mhdsilva/flywire-arduino/README.md

# FlyWire on Arduino 🪰 — a fly brain driving an Arduino

**A real *Drosophila melanogaster* brain circuit running on a laptop CPU and
controlling physical hardware.**

I took the public [FlyWire](https://flywire.ai) connectome — the synapse-by-synapse map of the
fly brain — extracted the subcircuit that detects "something approaching" and triggers escape, and
wired it into an Arduino. Activity in the *Giant Fiber* (DNp01) continuously controls
the amplitude and frequency of a servo oscillation. When that activity fades,
the servo returns to rest. The connections drive the neural response; a short
rate filter and an engineered oscillator translate it into physical movement.

> **TL;DR:** A real fruit-fly connectome (FlyWire FAFB v783) reduced to a 583-neuron
> looming→escape subcircuit, simulated with a sparse LIF model on a laptop CPU (~0.9× real
> time) and closed into a physical loop via an Arduino: potentiometer = looming sense, three
> LEDs = the three neural stages, servo = flapping wings. Recent motor firing
> controls the movement continuously, with no predetermined flight duration.

---

## How it works

```
   [Arduino UNO]                          [Laptop]                        [Arduino UNO]
   potentiometer  ─── serial 115200 ───►  connectome FlyWire ─── serial ───►  3 LEDs
   (the "looming")    "S <ldr> <ntc>      LC4/LPLC2 → inter → DNp01           (stages)
                       <pot> <btn>"       (583 neurons, LIF, CPU)            servo
                                          ▲                                     (wings)
                                          └──────────── "L <s> <i> <m> <ang>" ─┘
```

- The **Arduino is the body**: it reads sensors, moves the servo, lights LEDs. Deliberately dumb.
- The **laptop is the brain**: it simulates the connectome and maps motor activity to servo commands.
- The loop closes at ~50 Hz over USB serial.

The potentiometer lets you "startle" the fly: a slow ramp is ignored, a sharp turn
becomes a strong *looming* that sweeps through the circuit and makes DNp01 fire.

## The brain (real data)

The data comes from Codex/FlyWire, snapshot **FAFB v783** (the complete adult brain of
`Drosophila`, ~139,255 neurons).

The subcircuit is extracted by `brain/build_circuit.py`:

| Role | Neurons | What it is |
|---|---|---|
| **Sensory** | 314 | LC4 + LPLC2 — visual *looming* detectors |
| **Interneurons** | 267 | what connects the two |
| **Motor** | 2 | DNp01 — the *Giant Fiber*, escape command |
| **Total** | **583** | 4,799 weighted connections between neuron pairs |

Simulation: sparse LIF in numpy/scipy (`brain/lif.py`), `dt = 0.1 ms`, `tau_m = 20 ms`,
`tau_syn = 5 ms`. Weights = synapse count, with sign by neurotransmitter
(GABA = inhibitory). Runs at **~0.9 s of CPU per 1 s of brain** on an i5-1135G7 — that is,
practically real time, with no GPU.

> The response depends on both the wiring and the chosen model parameters. In `--dry-run`,
> `stim = 0` → the motor stays quiet; `stim = 0.2` → it fires.

## The behaviour

`FlightBehavior` in `brain/run_brain.py` continuously reads motor spikes:

1. Estimate the mean DNp01 firing rate with a **100 ms exponential filter**.
2. Use that rate to set oscillation amplitude (up to ±50° around 90°) and
   frequency (0.7–2 Hz while active), with a command speed limit of 300°/s.
3. Keep sensing during movement: new activity can strengthen or sustain it.
4. As the rate falls below the readout threshold, return to 90°. Ignore sensor
   input for 0.5 s after this transition to reduce landing noise.

There is **no random duration or flight timer**. Brief stimuli now produce brief
movements: this circuit did not sustain seconds of motor firing after a short
pulse. The smoothing, activity thresholds and sinusoid remain engineered choices;
the oscillation itself does not emerge from the neural network. The green LED
reports motor spikes in the current window, so it can go dark while the smoothed
servo output is still returning to rest.

Measurements, the readout equations and reproduction commands are in
[`docs/NEURAL-CONTROL.md`](docs/NEURAL-CONTROL.md).

The LDR-to-servo path was tested on the physical Arduino on **2026-09-12**.
After observing the brief movements, the operator chose to preserve the current
neural response rather than extend it in the servo controller. The
[bench record and decision](docs/NEURAL-CONTROL.md#physical-bench-trial--2026-09-12)
include the results and the limits of that functional check.

### Two ways to startle it

`--sensor` picks what drives the looming stimulus:

- **`--sensor pot`** (default) — the potentiometer on **A2**. *Approaching* = a sharp
  counter-clockwise turn.
- **`--sensor ldr`** — the light sensor on **A0**. *Approaching* = a sudden rise in light:
  keep the room dark (LDR ≈ 50) and arrive with a flashlight. The light is the "predator" and
  the fly bolts. (You can invert the staging — lit at rest, a hand casts a shadow — by flipping
  the LDR `direction` to `-1` in `SENSORS`.)

Both share the same filtering: a median filter to kill spikes, a dead band so that noise and
slow changes are ignored, and a refractory period after each escape.

## Hardware

Wiring schematic

Eletrogate "Kit Start" kit (Arduino UNO R3):

| Component | Pin | Role in the project |
|---|---|---|
| Micro servo SG90 | 9 | wings (flies) |
| Red LED | 5 | **sensory** stage (LC4/LPLC2) |
| Yellow LED | 6 | **interneuron** |
| Green LED | 7 | **motor** (Giant Fiber) |
| Potentiometer 10 kΩ | A2 | *looming* — the startle (`--sensor pot`) |
| LDR (light) | A0 | *looming* — a flashlight arriving (`--sensor ldr`) |
| NTC 10 kΩ | A1 | *(optional)* temperature |
| Button | 2 | *(optional)* |
| Buzzer | 8 | *(optional)* |

Assembly and wiring details are in the header of `board/flywire/flywire.ino`.

Full build guide — bill of materials, breadboard basics, step-by-step wiring,
power/noise notes, bench self-test and troubleshooting:
[`docs/HARDWARE.md`](docs/HARDWARE.md). The diagram above is generated by
`docs/make_schematic.py`.

### Noise protection (bench learning)

The servo injects noise into the rails when it moves, and that shows up in the pot reading. Two
capacitors help:

- **100 nF** (ceramic) between the analog input (**A2** for the pot, or **A0** for the LDR) and
  **GND** — filters high-frequency noise at the input.
- **100 µF** (electrolytic, mind the polarity) between **5 V and GND** near the servo — current
  reserve for the peaks.

In addition, the Python controller has a median filter, a dead band and a brief
input guard after motor activity subsides. Input remains live during movement,
so physical filtering is still needed to avoid servo noise sustaining activity.

## How to run

### 1. Tools

```bash
# arduino-cli (no sudo, inside the project)
mkdir -p bin && curl -fL https://downloads.arduino.cc/arduino-cli/arduino-cli_latest_Linux_64bit.tar.gz \
  | tar -xz -C bin arduino-cli
export PATH="$PWD/bin:$PATH"
arduino-cli core install arduino:avr
arduino-cli lib install Servo

# python
python3 -m venv .venv
.venv/bin/pip install pyserial numpy scipy pandas

# serial port access (once; requires re-login)
sudo usermod -a -G dialout "$USER"
```

### 2. Data and circuits

```bash
.venv/bin/python brain/fetch_data.py      # downloads the FlyWire data (~50 MB)
.venv/bin/python brain/build_circuit.py   # generates brain/data/circuit.npz
```

> If you cloned the repo, `circuit.npz` already comes ready — you can skip this step and just run.

### 3. Flash the Arduino

```bash
arduino-cli compile --fqbn arduino:avr:uno --upload -p /dev/ttyACM0 board/flywire
```

On boot it runs a self-test: sweeps the servo, lights the LEDs in sequence, beeps the buzzer
(if connected). If you see this, the hardware is alive.

### 4. Run the brain

```bash
# without hardware (simulation only)
.venv/bin/python brain/run_brain.py --dry-run --stim 0.2 --seconds 1
.venv/bin/python brain/run_brain.py --fake --seconds 14

# real loop, potentiometer: a sharp twist startles it
cd brain && sg dialout -c '../.venv/bin/python -u run_brain.py --port /dev/ttyACM0 --seconds 0'

# real loop, light sensor: keep the room dark, arrive with a flashlight
cd brain && sg dialout -c '../.venv/bin/python -u run_brain.py --port /dev/ttyACM0 --sensor ldr --seconds 0'
```

`--seconds 0` runs until you press Ctrl-C.

## Verification

```bash
.venv/bin/python -B -m unittest discover -s tests -v
```

The 12 tests cover the continuous readout, the real saved neural circuit, both
sensor filters, synthetic and simulated serial operation, and reset after a
serial reconnection. Test details and pulse-response reproduction commands are
in [`docs/NEURAL-CONTROL.md`](docs/NEURAL-CONTROL.md).

## Engineering notes (what broke along the way)

Worth recording, because it was the most interesting part:

- **Serial buffer**: the Uno transmits sensors at 50 Hz. If the host does not drain the reading, the
  board's TX buffer fills up, its loop blocks and the PC's `write()` hangs forever. Solution:
  always drain and `write_timeout=1`.
- **`dt ≈ 0` with a full buffer**: processing several delayed samples with the same clock made
  `d(pot)/dt` explode and the noise turn into "looming". Solution: process only the most recent sample
  and use the nominal `dt` (20 ms).
- **Renewable flinch**: timer extensions once made jitter prolong movement. The
  current readout uses a continuously filtered motor rate instead of renewing a timer.
- **Noise cycle**: noise fires → servo moves → servo injects noise → fires again.
  Solution: refractory period + capacitors.
- **The SG90 is positional**: it does not spin 360°, it only goes from 0 to 180° and holds. That is not a bug.

## Experiments

The bench demo is also a bench for measurements. [`docs/EXPERIMENTS.md`](docs/EXPERIMENTS.md)
fixes the design — a shared stimulus protocol, honest metrics, and four experiments:
**ablation** (which neurons are necessary), **null model** (does the specific wiring
matter, or would any graph with the same degree sequence do?), **dose–response** (how
sharp the threshold is) and **latency** (in-silico vs the hardware loop).

The design was written before the code, so the experiments cannot be tuned into
telling a nicer story afterwards — and it paid off: at a single near-threshold
stimulus the ablation looked like "LC4 and LPLC2 are each individually necessary",
which the amplitude sweep showed to be an artefact.

Results and the honest reading: [`experiments/FINDINGS.md`](experiments/FINDINGS.md).
The code and commands: [`experiments/README.md`](experiments/README.md).

## What is real and what is simplified

**Real:** the topology of the connections (who connects to whom, with how many synapses) and the
identity of the neurons (LC4, LPLC2, DNp01) come from the connectome. Neural activity
depends on that wiring and the configured LIF parameters.

**Simplified:** the neuron model is LIF (not biophysical); synapses are static; the
neurotransmitters are treated as excitatory (GABA inhibitory); no plasticity; the body
is a servo, not real biomechanics. The rate filter, servo oscillator, thresholds
and movement limits are engineered mappings. It is a serious *toy*, not a paper.

## License and attribution

Code: **MIT** (see `LICENSE`).
Connectome data and derived artefacts (`brain/data/circuit.npz`): **CC BY-NC 4.0**
(non-commercial), from the FlyWire consortium.

References:

- Dorkenwald, S. et al. *Neuronal wiring diagram of an adult brain.* Nature (2024).
- Schlegel, P. et al. *Whole-brain annotation and multi-connectome cell typing of Drosophila.* Nature (2024).
- Shiu, P. K. et al. *A leaky integrate-and-fire computational model based on the connectome of the entire adult Drosophila brain.* Nature (2024).
- FlyWire / Codex — https://codex.flywire.ai
