mhdsilva/flywire-arduino/docs/cover.png

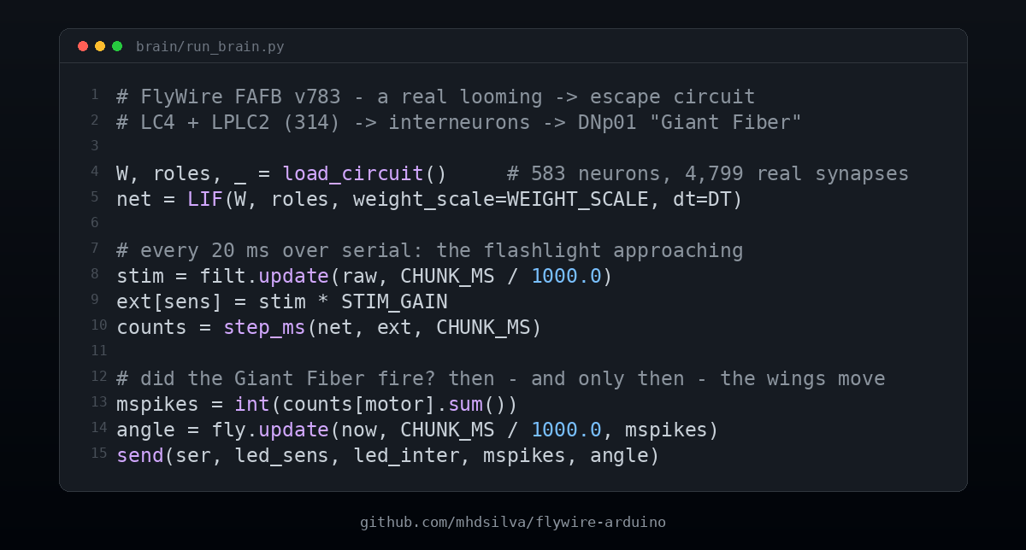
docs/cover.png
