mhdsilva/flywire-arduino/docs/schematic.png

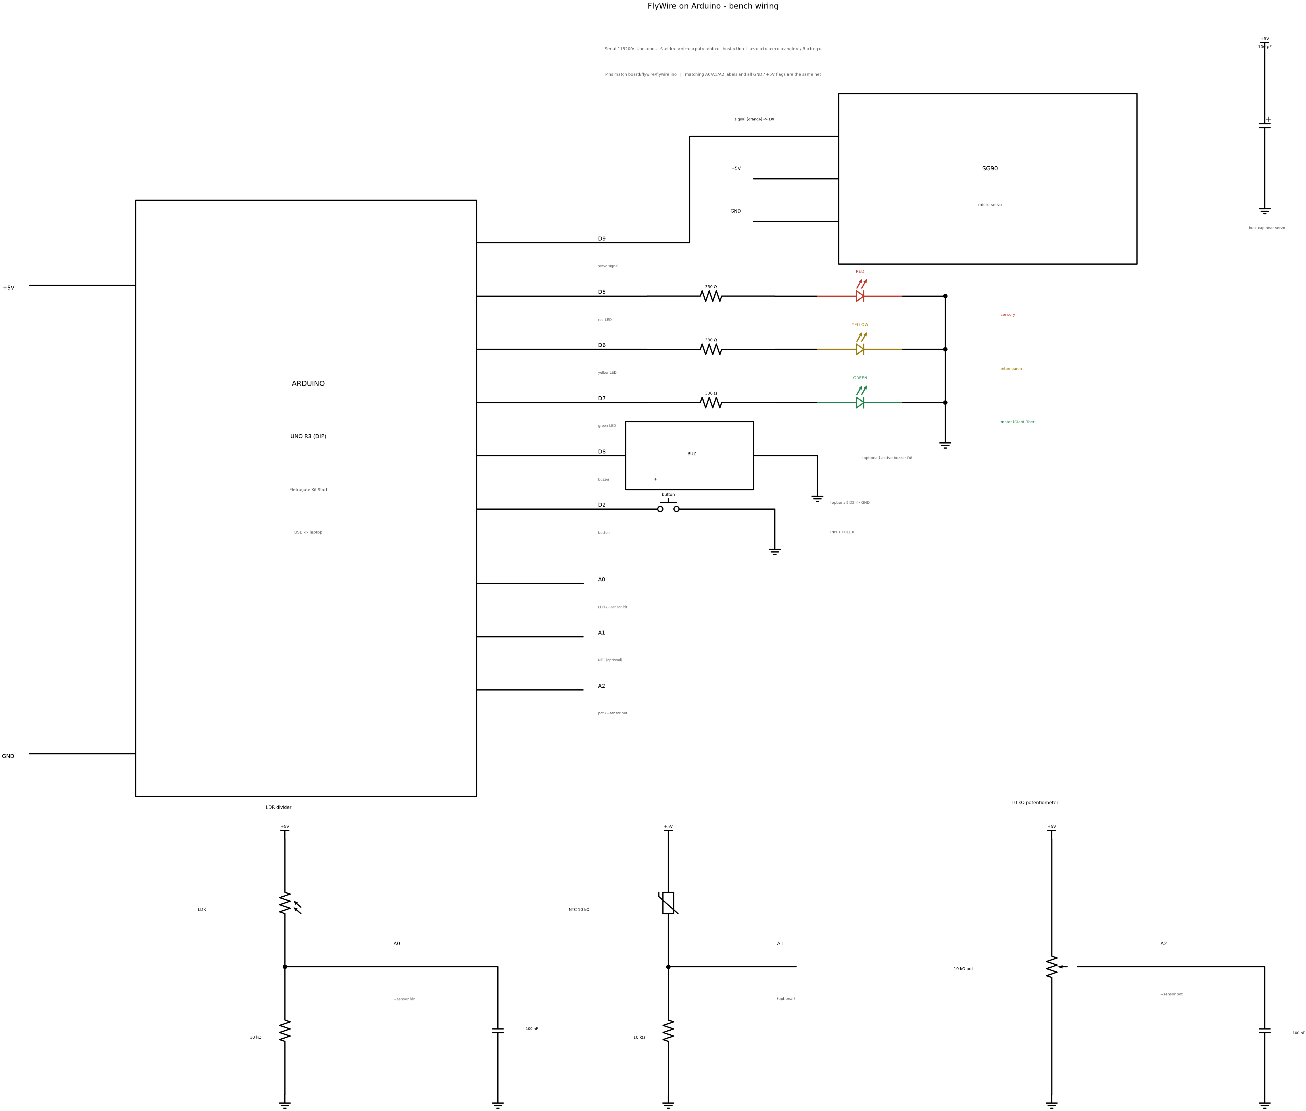
docs/schematic.png
