mhdsilva/flywire-arduino/experiments/README.md

# Experiments

Implementation of the experimental design in [`docs/EXPERIMENTS.md`](../docs/EXPERIMENTS.md).
The design document is the spec: it fixes the protocol, metrics and interpretation.
This file documents how the code implements them; the results live in
[`FINDINGS.md`](FINDINGS.md).

## Documentation map

| file | role |
|---|---|
| [`docs/EXPERIMENTS.md`](../docs/EXPERIMENTS.md) | **the design** — protocol, metrics, interpretation rules. Written before the code; the spec |
| `README.md` (this file) | **how to run** — commands, protocol implementation, semantics, timings |
| [`FINDINGS.md`](FINDINGS.md) | **what came out** — results, honest reading, caveats, article angles, open questions |
| `results/*.csv` | raw per-run output (gitignored); `FINDINGS.md` quotes them |

All runners import `experiments/harness.py`, which is the single implementation of
the shared protocol. If the protocol changes, it changes there once.

## Shared protocol

`harness.run_trial(amp, pulse_ms=100.0, ablate=None, weights=None, seed=0, noise_sigma=0.0)`:

1. **Reset** (`LIF.reset()`).
2. **Warm-up:** 200 ms, no stimulus.
3. **Pulse:** rectangular stimulus of amplitude `amp` for `pulse_ms`, applied to
   the sensory neurons only: `ext[sensory] = amp * STIM_GAIN`.
4. **Readout:** 500 ms, no stimulus.

Integration uses the repo constants `DT = 0.1 ms`, `WEIGHT_SCALE = 3e-4`,
`STIM_GAIN = 0.5` and `run_brain.step_ms`. Motor spikes are counted over the
pulse + readout window (600 ms); the warm-up never enters a metric. `ablate` and
`weights` are the modification hooks (see below), and `noise_sigma` is the
injected-noise hook.

### Baseline amplitude

Default `amp = 0.2`. This was calibrated against the protocol, not assumed:
a 100 ms pulse gives 0 spikes at 0.10 and 0.12, 1 at 0.15, 4 at 0.18, 6 at 0.20
(first spike 32.4 ms), up to 32 at 1.0. So 0.2 clearly triggers the escape
without saturating — there is headroom toward `amp = 1`. The repo's earlier
continuous-stimulus measurement (0.2 fires, 0.1 does not) is consistent with
this.

### Determinism and injected noise — read this

The LIF model in `brain/lif.py` has **no stochastic term** and was not modified.
With the default `noise_sigma=0.0`, `seed` is accepted for protocol compliance
but does not change a trial: the same `amp` gives bit-identical metrics for every
seed. No noise has been invented to manufacture trial-to-trial variance.

Passing `noise_sigma > 0` adds an **explicitly injected** stochastic drive to the
external current of the sensory neurons at every integration step of the pulse
and readout windows (never the warm-up). A per-trial RNG seeded from `seed` makes
the run reproducible: the same seed reproduces a trial exactly, a different seed
gives a different draw. This injected stimulus is the only source of
stochasticity; the neuron model, synapses and readout are unchanged. `noise_sigma`
is in the same units as `STIM_GAIN` (external current; threshold = 1.0), and the
psychometric threshold location is a function of it.

Consequence for the dose–response: with `noise_sigma=0.0`, all `--trials` repeats
at one amplitude are identical, so `trigger_probability` is exactly 0 or 1 and the
reported threshold is a sharp step — the honest result for this model. With noise
the repeat becomes a draw, so `trigger_probability` can be graded; the graded
window is narrow at small `σ` because the membrane/synapse low-pass filters white
noise. See [`FINDINGS.md`](FINDINGS.md) §5.

## Metrics

| Metric | Definition |
|---|---|
| `motor_spikes` | total DNp01 spikes over pulse + readout |
| `first_spike_ms` | pulse onset → first DNp01 spike, or `None` |
| `peak_rate_hz` | max DNp01 spikes in a 20 ms bin / 0.02 / `n_motor` |
| `triggered` | `motor_spikes > 0` |
| `bins_with_spikes` | number of 20 ms bins containing a DNp01 spike |

## Ablation semantics — remove, not silence

An ablated neuron is taken out of the network: its incoming **and** outgoing
edges are zeroed (`D @ W @ D`), it receives no stimulus, and (for motor) it is
excluded from the readout. This is a full lesion. It is deliberately *not* a
membrane clamp, which would leave the synapses in place. Cell types come from the
`sensory`/`inter`/`motor` roles or the FlyWire `primary_type` in `node_types`.

## Experiments

### 1. Ablation — `ablation.py`

Default conditions: `baseline`, `LC4`, `LPLC2`, `sensory`, `inter`, `motor`.

**The amplitude sweep is the point.** Every condition runs across several stimulus
amplitudes (`--amps`, default `0.2 0.35 0.5 0.75 1.0`) and each cell is
`motor_spikes (% of baseline)`. At a near-threshold amplitude, losing any drive can
abolish the response and look "necessary"; only at suprathreshold amplitudes does
the group's real contribution appear. A single amplitude would hide that — and
would have supported a false claim.

With `--types`, the runner profiles the whole cell-type inventory instead: it
ablates **every** non-empty FlyWire `primary_type` with at least `--min-cells`
neurons (default 10), plus the baseline. At the default threshold only LC4 and
LPLC2 qualify; lower it to inspect the long tail (all other types are 1–8-cell
interneurons, so `--min-cells 1` covers everything).

```
.venv/bin/python experiments/ablation.py                              # ~20 s
.venv/bin/python experiments/ablation.py --amp 0.5                    # a single amplitude
.venv/bin/python experiments/ablation.py --types                      # default --min-cells 10
.venv/bin/python experiments/ablation.py --types --min-cells 1        # whole inventory, ~432 s
```

Default mode writes `results/ablation.csv`; `--types` writes
`results/ablation_types.csv` (same columns, one row per amplitude x condition).

### 2. Null model — `null_model.py`

Two nulls, run through the identical protocol:

1. **Degree-preserving directed rewiring (primary).** Repeated directed
   double-edge swaps. A swap takes edges `a→b`, `c→d` and makes `a→d`, `c→b`,
   which preserves every node's in- and out-degree exactly. Weights stay with
   their edge index, so the weight multiset is unchanged. Swaps that would make a
   self-loop or a duplicate edge are rejected. For every sample the code verifies
   the in/out degree sequences against the real circuit and prints the maximum
   absolute difference (must be 0).
2. **Erdős–Rényi (secondary).** The same number of edges placed uniformly at
   random over the same 583 nodes (no self-loops), with the real weight multiset
   permuted onto those edges. No degree constraint — the "any sparse graph"
   baseline.

```
.venv/bin/python experiments/null_model.py --n 20     # ~42 s
.venv/bin/python experiments/null_model.py            # default --n 50, ~104 s
.venv/bin/python experiments/null_model.py --n 100    # ~207 s
```

Writes `results/null_model.csv` (one row per sample plus a tagged `real` row) and
prints, for `motor_spikes` and `first_spike_ms`, the null mean, sd and the
percentile of the real value. For latency a *low* percentile is the fast/strong
outcome; non-firing nulls are ranked as `+inf`, and the number that fired is
printed.

### 3. Dose–response — `dose_response.py`

Sweeps `amp` over `0 .. 1` in `--points` steps with `--trials` repeats (new seed
per trial). Prints trigger probability, mean ± sd `motor_spikes` and mean
`first_spike_ms`.

With the default `--noise-sigma 0.0` the run is deterministic and writes
`results/dose_response.csv` (unchanged format). With `--noise-sigma > 0` the
sensory external current gets the injected drive described above, the curve can
be graded, and the run writes `results/dose_response_noise.csv` (with an added
`sd_motor_spikes` and `noise_sigma` column). The graded window can be narrower
than the default 9-point grid; use `--points`/`--amp-max` to zoom in.

```
.venv/bin/python experiments/dose_response.py --trials 20 --noise-sigma 0.0    # ~128 s
.venv/bin/python experiments/dose_response.py --trials 20 --noise-sigma 0.05   # ~162 s
.venv/bin/python experiments/dose_response.py --points 16 --amp-max 0.3 \
    --trials 20 --noise-sigma 0.5                                              # ~304 s
```

### 4. Latency — `latency.py`

Measures the **hardware loop** on the real board, keeping it separate from the
in-silico neural latency. It needs the `P` ping command in the Uno firmware
(`board/flywire/flywire.ino`), which replies immediately with `P <micros()>`:

```bash
PATH="$PWD/bin:$PATH" arduino-cli compile --fqbn arduino:avr:uno board/flywire
sg dialout -c 'PATH="$PWD/bin:$PATH" arduino-cli upload --fqbn arduino:avr:uno -p /dev/ttyACM0 board/flywire'
```

Then:

```bash
sg dialout -c '.venv/bin/python experiments/latency.py'   # ~9 s, board at /dev/ttyACM0
```

Five stages, each printed with its raw distribution: serial round trip (`P`
ping), `S`-line inter-arrival jitter, host per-iteration cost (`read S -> 20 ms
network chunk -> write L`), in-silico `first_spike_ms`, and a derived
servo-slew estimate. The budget table labels every stage `measured` or
`derived`. Raw samples go to `results/latency.csv` with columns
`kind,index,value_ms` (`kind` is `ping_rtt` or `s_interval`).

The runner works with `--port`/`--baud` and `--pings`/`--s-samples`/
`--loop-iters`/`--amp`. Without a board (or without the `P` command) it prints
the in-silico number, says what could not be measured, and exits cleanly — it
never invents a timing. Measured wall time on the 2026-09-12 bench: **8.8 s**
for the default run (allow ~12 s on a cold USB start).

### Harness self-test

```
.venv/bin/python experiments/harness.py --amp 0.2                          # ~1.4 s
.venv/bin/python experiments/harness.py --amp 0.2 --noise-sigma 0.05 --seed 1
```

## Results

The results, their interpretation, the caveats and the article angles live in
[`FINDINGS.md`](FINDINGS.md), so this file stays about *how* to run the
experiments. Headline: across the amplitude sweep, LC4 and LPLC2 each carry about
half the drive (neither is individually necessary) and no other cell type carries
a meaningful share; the interneurons are net-inhibitory in aggregate; the real
circuit sits at the 99th–100th percentile of a degree-preserving null; and an
injected stochastic drive turns the deterministic step into a graded psychometric
curve whose threshold moves with the injected noise.

## What this does and does not show

**Does:** quantify the response of this specific 583-neuron subcircuit (sensory
314, inter 267, motor 2; LC4 104, LPLC2 210, DNp01 2) to controlled in-silico
stimuli, test whether the specific topology carries information beyond its
degree sequence, show what an explicitly injected stochastic drive does to the
response threshold, and measure the physical Arduino loop latency on the bench
(§4), where the actuator — not the connectome — dominates.

**Does not:** demonstrate biological realism. The neuron model is LIF, synapses
are static, transmitters are collapsed to a sign, this is a small subcircuit and
not the whole brain, and the servo/flight readout is an engineered mapping. The
injected noise is a stimulus we chose, not a property of the model or the brain:
`σ` is arbitrary, unfitted and added only to the sensory external current, so
the psychometric threshold it produces is conditional on `σ`. These are honest
toys with real wiring.

## Pointer

The questions, protocol, metric definitions and reading instructions are fixed in
[`docs/EXPERIMENTS.md`](../docs/EXPERIMENTS.md). This file only documents the
implementation; when the two disagree, the design document wins.
