mhdsilva/flywire-arduino/(commit log)

2026-09-12 Initial commit: a fruit-fly connectome driving an Arduino
    Real FlyWire FAFB v783 looming->escape subcircuit (LC4/LPLC2 -> inter -> DNp01, 583 neurons / 4,799 synapses), simulated with a sparse LIF model and closed into a physical loop with an Arduino UNO. Includes the data fetcher, subcircuit builder, LIF sim, closed-loop runner, the Arduino sketch (servo wings, 3 stage LEDs, sensor serial protocol) and bench tools. The escape/flight behaviour emerges from the wiring, not from scripted logic; runs on CPU at ~0.9x real time.
2026-09-12 Rename project to FlyWire on Arduino
    - repo/sketch renamed: board/mosca_test -> board/flywire (flywire.ino), boot message updated
    - brain/recon.py: hardcoded absolute path replaced by a path relative to the file, so it works for anyone who clones
    - README title and references updated
    [flywire.ino, recon.py, serial_console.py]
2026-09-12 Add light-sensor (LDR) startle via --sensor ldr
    - run_brain.py: --sensor {pot,ldr} with per-sensor field, direction and dead band
    - LDR staging: dark at rest (~50), a flashlight arriving is the looming stimulus
    - README: document the two ways to startle the fly; update the hardware table
    - verified on hardware: the light startle triggers a flight
2026-09-12 Add hardware docs and a generated wiring schematic
    - docs/HARDWARE.md: BOM, pinout, breadboard basics, step-by-step wiring,
    power/noise, bench bring-up, troubleshooting, the two startle inputs
    - docs/make_schematic.py (schemdraw) -> docs/schematic.svg + docs/schematic.png
    - README: embed the schematic and link the hardware guide
2026-09-12 feat: control servo continuously from neural activity
    Replace timed flights with a continuous motor-rate readout and reset transient state after serial reconnection. Add 12 regression and integration tests, document pulse measurements and the physical LDR bench trial, and record the decision to preserve the circuit's brief response.
    [run_brain.py]
2026-09-12 Tune neural servo readout so a startle produces a visible flight
    - RATE_TAU_S 0.10 -> 0.50 s: the flight now lasts as long as the spike rate takes to decay, instead of a fraction of a second
    - latch the episode PEAK drive to the flap amplitude so the wings do not collapse as the rate decays (before: a single arc, ~0.6 s, barely moved)
    - FLAP 0.7-2.0 -> 0.6-1.2 Hz and slew 300 -> 450 deg/s so the SG90 can actually follow (2 Hz x +-50 deg needed ~630 deg/s)
    - measured: one fast flick -> ~1.8 s episode, ~2 wing beats, ~+-26 deg around rest; still entirely driven by the network response (bigger burst => bigger AND longer)
    - tests updated to the new semantics (slew bound derived from SERVO_SPEED_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
2026-09-12 Gate the sensor during the flap so the flight cannot self-sustain
    The moving SG90 injects electrical noise into the analog input, and those per-sample jumps are LARGER than the real light signal (the LDR swings ~50-100 counts while the wings move, against a genuine flashlight step of a few tens per sample). With the input live throughout the flight the loop never landed: observed ~29 s and 1227 motor spikes before being stopped by hand.
    - keep the sensor live for CAPTURE_S = 0.25 s after take-off (the servo is still near rest, phase 0 targets the rest angle), then mute until landing plus a 0.5 s guard. The network's whole response is captured, so amplitude and duration stay network-decided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
    [run_brain.py]
2026-09-12 Make the startle trigger much more sensitive
    - RATE_ON_HZ 5 -> 2 and RATE_OFF_HZ 2 -> 0.8: raising the rate time constant to 0.80 s made the old 5 Hz gate miss a normal flashlight approach
    - LDR_DEAD 500 -> 250: a gentle ~2 s rise from dark to flashlight now triggers; with the old dead band even a 1.6 s approach produced no stimulus at all
    - measured with the LDR config: 0.2 s rise -> 3.24 s flight, 1.0 s -> 3.34 s, 2.0 s -> 1.22 s, 3.0 s -> no flight
    - tests extended for the longer episodes; docs synced (thresholds + sensitivity table)
    - NOTE: the 100 nF input capacitor is currently removed; without it the LDR rest noise is up to 163 counts in a single sample, which with the lower threshold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
    [run_brain.py]
2026-09-13 Implement the experiments: ablation, null model, dose-response
    - experiments/harness.py is the single implementation of the protocol fixed in docs/EXPERIMENTS.md (200 ms warm-up, rectangular pulse to the sensory neurons, 500 ms readout; remove-not-silence ablation via D @ W @ D; custom weights for the nulls)
    - ablation is reported ACROSS amplitudes, and that matters: at a near-threshold amplitude losing LC4 or LPLC2 abolishes the response and reads as 'individually necessary', while at suprathreshold amplitudes each only contributes ~half the drive. The interneurons are net-inhibitory (removing them raises the output 3-17% at every amplitude)
    - the degree-preserving null preserves the in/out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
    [ablation.py, dose_response.py, harness.py, null_model.py]
2026-09-13 Injected-noise psychometric, per-type ablation, n=100 null
    - harness: optional seeded noise injected into the sensory external current (pulse + readout, never the warm-up). With noise_sigma=0 the protocol is bit-identical to before; the neuron model is untouched and this is the only source of stochasticity
    - dose_response: --noise-sigma; at sigma 0.02-0.1 the curve is still a step, because noise KILLS the knife-edge amp=0.125 response (1/20 -> 0/20) rather than smoothing it, so the threshold moves up. A real sigmoid needs finer sampling in 0.12-0.16 or sigma ~0.5 (p(0.12)=0.60, p(0.14)=1.00). Reported as is
    - ablation --types: only LC4 (104) and LPLC2 (210) carry a substantial share; no sing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
    [ablation.py, dose_response.py, harness.py]
2026-09-13 Measure the hardware loop latency (experiment section 4)
    - firmware: add a backward-compatible P ping (replies 'P <micros()>'), the only way to isolate the serial round trip without guessing. Protocol, self-test and pin map unchanged
    - experiments/latency.py measures the serial round trip (mean 4.07 ms, sd 0.20, n=100), the sensor sampling jitter (mean 20.01 ms, sd 1.25, min 16.3 max 20.9) and the host brain step (mean 16.32 ms per 20 ms chunk), and prints a budget table where every number is labelled measured or derived
    - FINDING: the actuator dominates. A 50 deg servo move (derived from the 450 deg/s command slew = 111 ms) is ~85% of the loop; the host brain step is ~12% and the USB round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
    [flywire.ino, latency.py]
2026-09-13 Complete the experiment documentation
    - experiments/README.md: a documentation map (design / how-to / findings / raw results) so the three files are navigable
    - experiments/FINDINGS.md: add the latency reproduce command and the sixth article angle ('your brain is fast, your servo is slow'), which section 7 had earned but the list did not yet name
